jezel-ayoub/IOT_SmartTrainSeats/3D Model/renders/1_outside.png

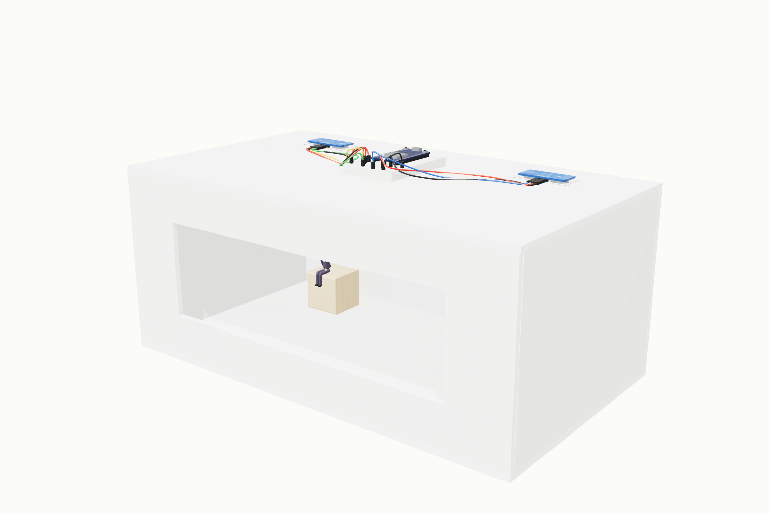
3D Model/renders/1_outside.png
