jezel-ayoub/IOT_SmartTrainSeats/3D Model/renders/2_cutaway.png

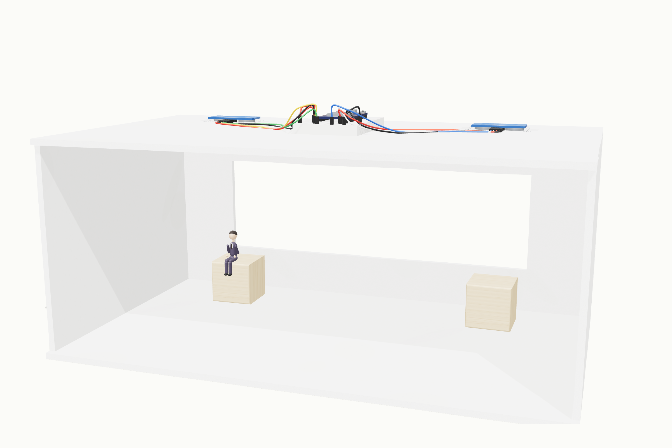
3D Model/renders/2_cutaway.png
