jezel-ayoub/IOT_SmartTrainSeats/3D Model/renders/3_sensor_above_seat.png

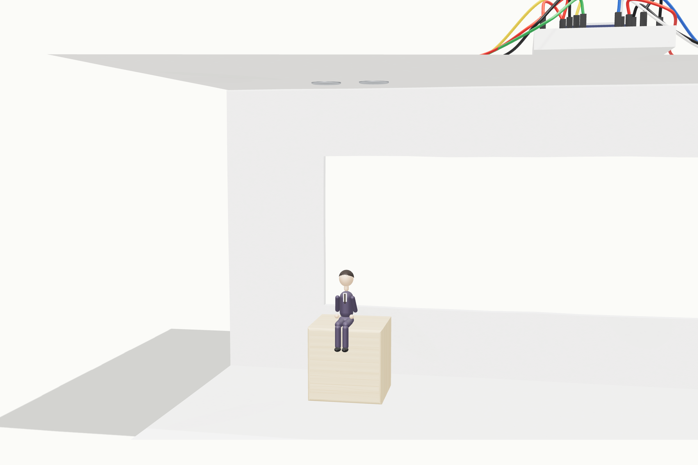
3D Model/renders/3_sensor_above_seat.png
