jezel-ayoub/IOT_SmartTrainSeats/3D Model/renders/4_from_above.png

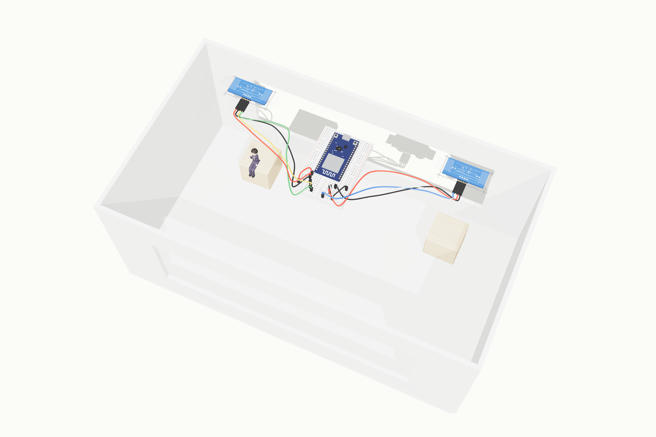
3D Model/renders/4_from_above.png
