jezel-ayoub/IOT_SmartTrainSeats/Simulation/sim_1_boarding_distribution.png

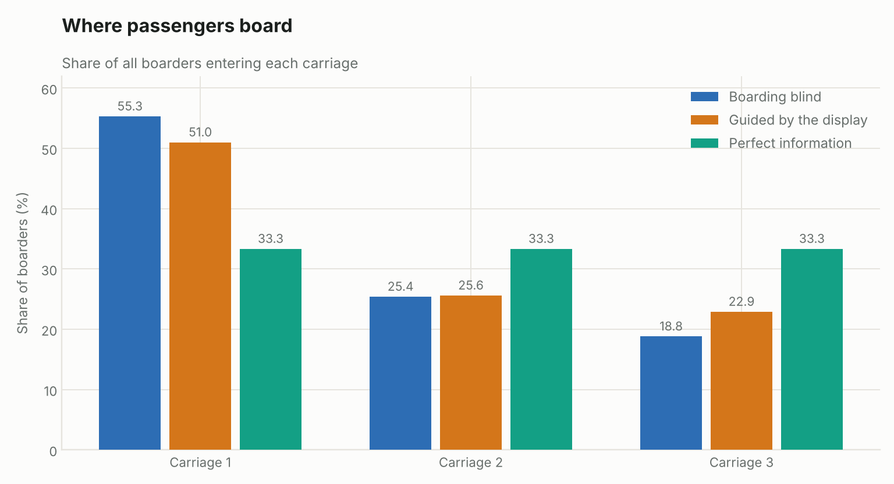
Simulation/sim_1_boarding_distribution.png
