jezel-ayoub/IOT_SmartTrainSeats/Simulation/sim_2_dwell_per_station.png

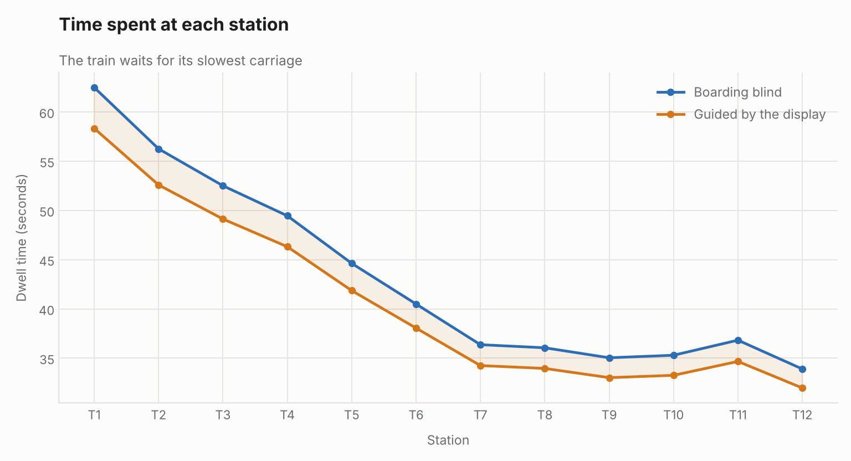
Simulation/sim_2_dwell_per_station.png
