jezel-ayoub/IOT_SmartTrainSeats/Simulation/sim_3_cumulative_saving.png

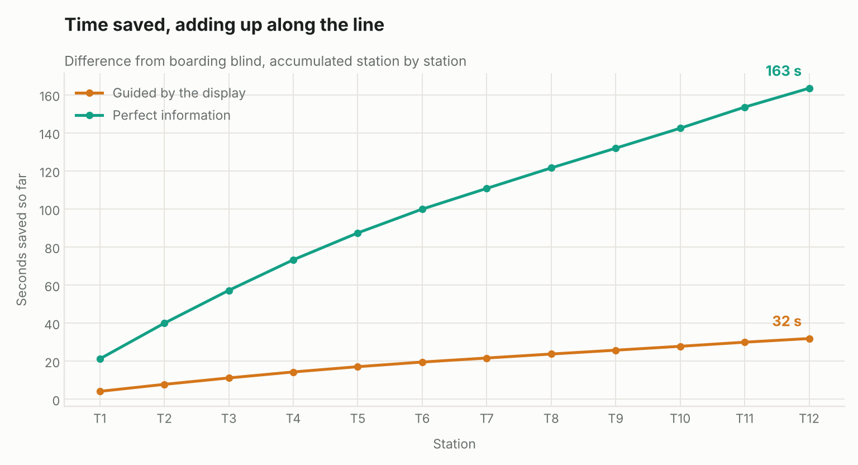
Simulation/sim_3_cumulative_saving.png
