jezel-ayoub/IOT_SmartTrainSeats/Simulation/sim_4_sensitivity.png

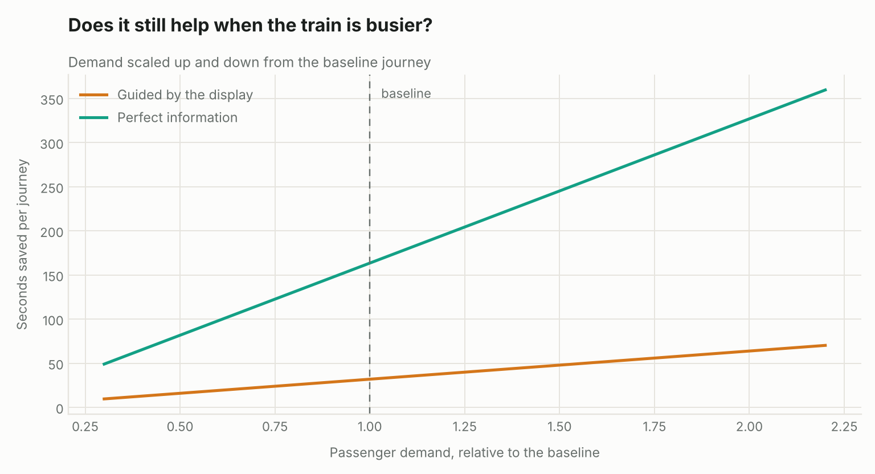
Simulation/sim_4_sensitivity.png
